manueligno78/esphome-therm-bus/enclosure/preview.png

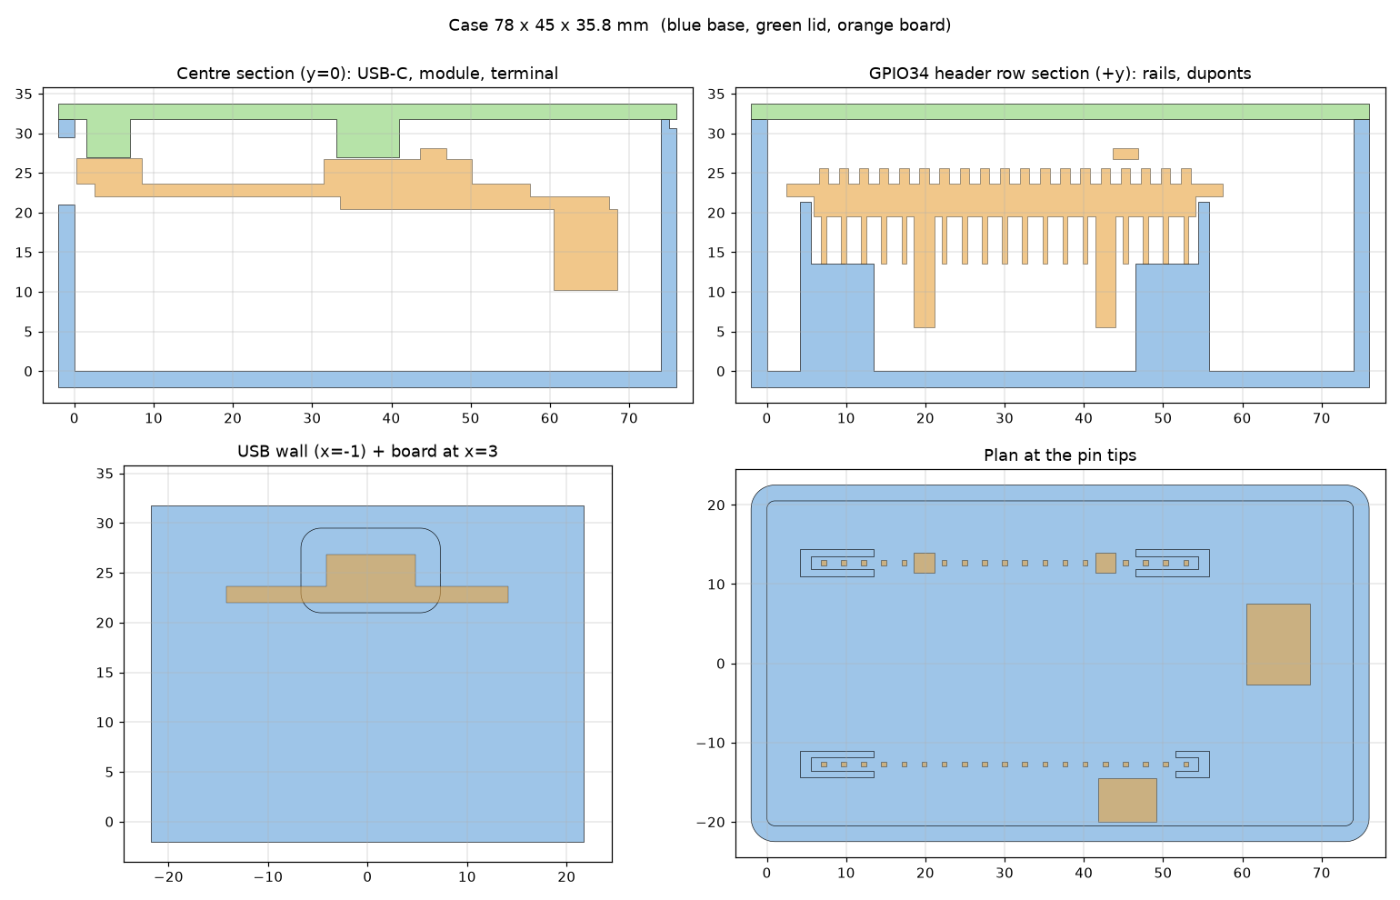
enclosure/preview.png
