manueligno78/esphome-therm-bus/enclosure/preview_3d.png

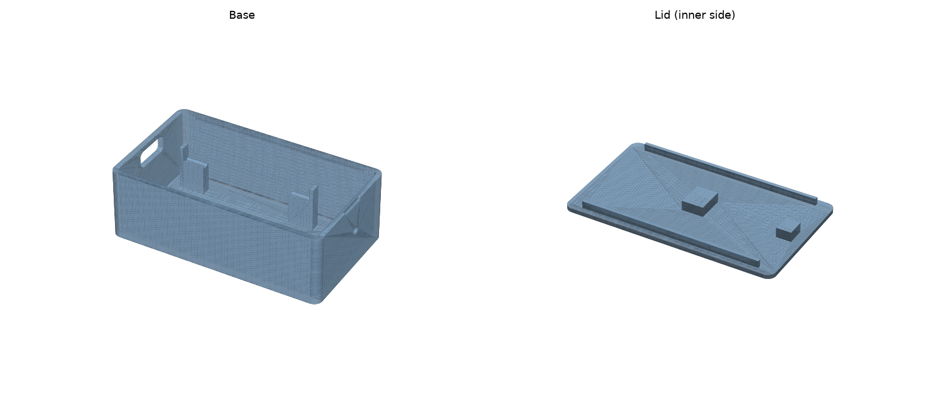
enclosure/preview_3d.png
