manueligno78/esphome-therm-bus/enclosure/case_lid.stl

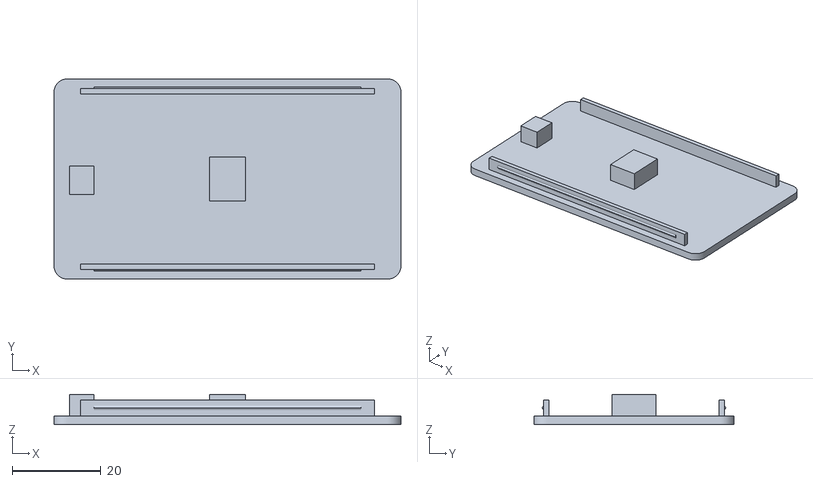
[picture p4: CAD file, 2026-11-06]
enclosure/case_lid.stl
78.0 x 45.0 x 6.84
