manueligno78/esphome-therm-bus/enclosure/case_base.stl

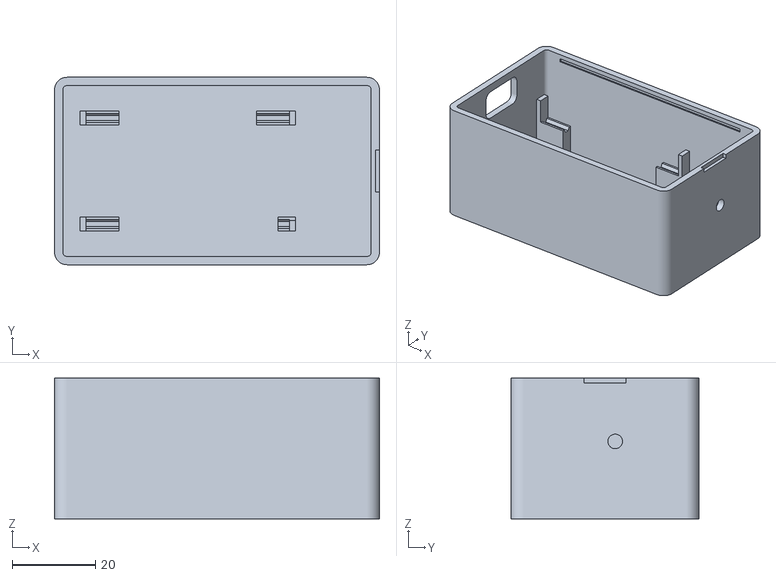
[picture p5: CAD file, 2026-11-06]
enclosure/case_base.stl
78.0 x 45.0 x 33.8
