manueligno78/esphome-therm-bus/(commit log)

2026-11-06 Initial release: read-only ESPHome gateway for the Bosch Therm remote bus
    - therm_bus external component: decodes the 4800 baud F5/FA frames and
    publishes temperatures, flow, burner power, flame, litres and raw frames
    - example config with gas power/energy/volume estimate, checked against
    the gas meter
    - PROTOCOL.md with the frame format, byte map and remote commands
    - printable enclosure (parametric, not print-tested yet)
    - sniffer firmware and scripts used to reverse engineer the bus
    [case_base.stl, case_lid.stl]
2026-11-06 Document compatible models and per-size gas factor
    Add a Compatibility section to the README: the tested T5600 O 15 V23,
    the rest of the Therm 5600 O range (same manual and wired remote), the
    Therm 5600 S (same wiring diagram, optional remote accessory), related
    models of the same platform still unverified, and models that cannot
    work. Include steps to check an unlisted heater safely.
    The gas factor is Qn / 100 and depends on the heater size (12/15/17 L:
    0.23/0.30/0.32 kW per %). List the values in the README, the example
    config and PROTOCOL.md, and note the LPG heating value for m3.
